hongph713/IOT_DATN/DATN_Hong/DATN_Hong.kicad_pcb

## KiCad design DATN_Hong/DATN_Hong.kicad_pcb (2025-06-25)

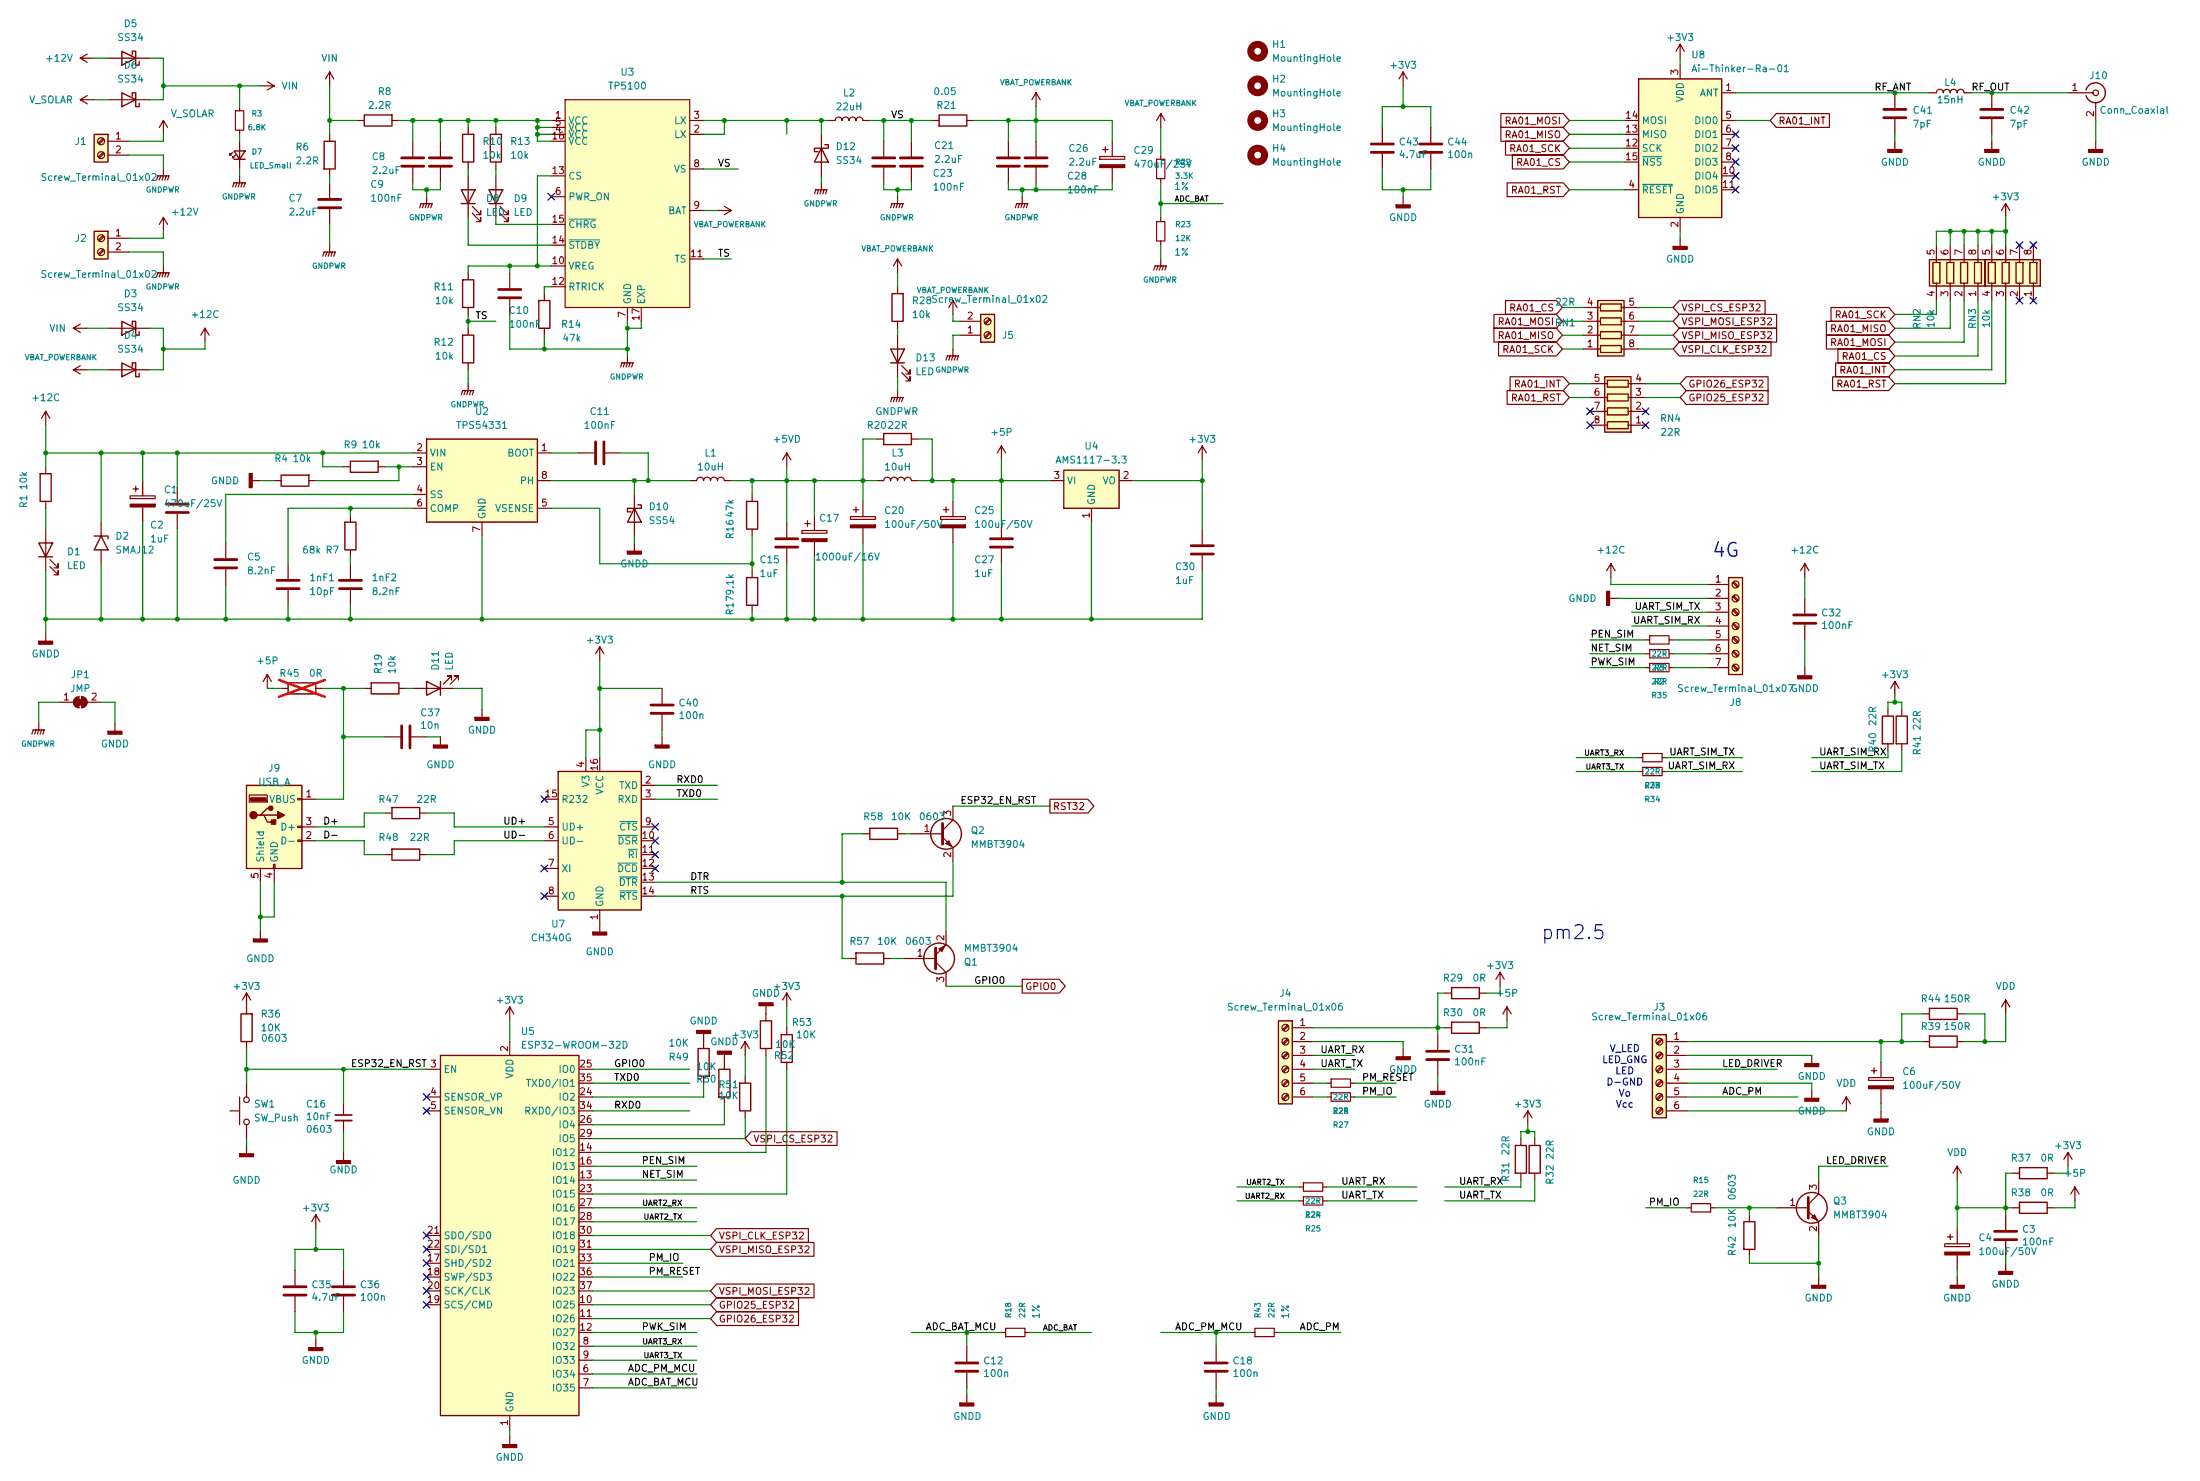
[picture p1: schematic DATN_Hong.kicad_sch]

Parts:
1nF1: 10pF; C_0603_1608Metric
1nF2: 8.2nF; C_0603_1608Metric
C1, C29: 470uF/25V; CP_Elec_10x10.5
C2, C15, C27, C30: 1uF; C_1206_3216Metric
C3, C31, C32: 100nF; C_0603_1608Metric; Part Description 10uF 10% 10V Ceramic Capacitor X7R 0805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
C4, C6, C20, C25: 100uF/50V; CP_EIA-7343-15_Kemet-W
C5: 8.2nF; C_0603_1608Metric
C7, C8, C21, C26: 2.2uF; C_1206_3216Metric
C9, C10, C11, C23, C28: 100nF; C_0603_1608Metric
C12, C18, C36, C44: 100n; C_0603_1608Metric; PART#1 G030617
C16: 10nF; C_0603_1608Metric; VOLTAGE 25V; PART#1 C021101
C17: 1000uF/16V; CP_Elec_10x10
C35, C43: 4.7uF; C_1206_3216Metric; PART#1 C020609
C37: 10n; C_0603_1608Metric
C40: 100n; C_0603_1608Metric
C41, C42: 7pF; C_0603_1608Metric
D1, D8, D9, D11, D13: LED; LED_0603_1608Metric
D2: SMAJ12; D_SMA
D3, D4, D5, D6, D12: SS34; D_SMA
D7: LED_Small; LED_0603_1608Metric
D10: SS54; D_SMA
H1, H2, H3, H4: MountingHole; MountingHole_3.2mm_M3
J1, J2, J5: Screw_Terminal_01x02; JST_VH_B2P-VH-B_1x02_P3.96mm_Vertical
J3, J4: Screw_Terminal_01x06; TerminalBlock_Xinya_XY308-2.54-6P_1x06_P2.54mm_Horizontal
J8: Screw_Terminal_01x07; PinHeader_1x07_P2.54mm_Vertical
J9: USB_A; USB_B_OST_USB-B1HSxx_Horizontal
J10: Conn_Coaxial; SMA_Amphenol_132291-12_Vertical
JP1: JMP; SolderJumper-2_P1.3mm_Bridged2Bar_RoundedPad1.0x1.5mm
L1: 10uH; L_12x12mm_H8mm
L2: 22uH; L_10.4x10.4_H4.8
L3: 10uH; L_Bourns-SRN4018
L4: 15nH; L_0603_1608Metric
Q1, Q2, Q3: MMBT3904; SOT-23
R1, R4, R9, R10, R11, R12, R13, R19, R28: 10k; R_0603_1608Metric
R2, R5, R15, R18, R24, R25, R26, R27, R33, R34, R35, R43, R47, R48: 22R; R_0603_1608Metric
R3: 6.8K; R_0603_1608Metric
R6, R8: 2.2R; R_1206_3216Metric
R7: 68k; R_0603_1608Metric
R14, R16: 47k; R_0603_1608Metric
R17: 9.1k; R_0603_1608Metric
R20: 22R; R_1206_3216Metric
R21: 0.05; R_1206_3216Metric
R22: 3.3K; R_0603_1608Metric; PART CLA0759
R23: 12K; R_0603_1608Metric
R29, R30, R37, R38: 0R; R_0603_1608Metric; Part Description Resistor 510K M1005 1% 63mW
R31, R32, R40, R41: 22R; R_0603_1608Metric; Part Description Resistor 510K M1005 1% 63mW
R36, R42, R49, R50, R51, R52, R53, R57, R58: 10K; R_0603_1608Metric
R39: 150R; R_1206_3216Metric; Part Description Resistor 510K M1005 1% 63mW
R44: 150R; R_Axial_DIN0207_L6.3mm_D2.5mm_P7.62mm_Horizontal; Part Description Resistor 510K M1005 1% 63mW
R45: 0R; R_0603_1608Metric; Part Description Resistor 510K M1005 1% 63mW; not fitted
RN1, RN4: 22R; R_Array_Convex_4x0603
RN2, RN3: 10k; R_Array_Convex_4x0603
SW1: SW_Push; SW_SPST_CK_RS282G05A3
U2: TPS54331; SOIC-8_3.9x4.9mm_P1.27mm
U3: TP5100; QFN-16-1EP_4x4mm_P0.65mm_EP2.1x2.1mm_ThermalVias
U4: AMS1117-3.3; SOT-223-3_TabPin2
U5: ESP32-WROOM-32D
U7: CH340G; SOIC-16_3.9x9.9mm_P1.27mm
U8: Ai-Thinker-Ra-01; Ai-Thinker-Ra-01-LoRa

Connections:
+3V3: C30.1, C35.1, C36.1, C40.1, C43.1, C44.1, R29.1, R31.1, R32.1, R36.2, R37.1, R40.1, R41.1, R51.2, R53.2, RN2.5 (R4.2), RN2.6 (R3.2), RN2.7 (R2.2), RN2.8 (R1.2), RN3.5 (R4.2), RN3.6 (R3.2), U4.2 (VO), U5.2 (VDD), U7.4 (V3), U7.16 (VCC), U8.3 (VDD)
+5P: C25.1, C27.1, L3.2, R20.2, R30.1, R38.1, R45.2, U4.3 (VI)
+5VD: C15.1, C17.1, C20.1, L1.2, L3.1, R16.2, R20.1
+12C: C1.1, C2.1, C32.1, D2.1 (A1), D3.1 (K), D4.1 (K), J8.1, R1.2, R9.1, U2.2 (VIN)
+12V: D5.2 (A), J2.1
/ADC_BAT: R18.2, R22.2, R23.1
/ADC_BAT_MCU: C12.1, R18.1, U5.7 (IO35)
/ADC_PM: J3.5, R43.2
/ADC_PM_MCU: C18.1, R43.1, U5.6 (IO34)
/D+: J9.3 (D+), R47.2
/D-: J9.2 (D-), R48.2
/DTR: Q1.2 (E), R58.2, U7.13 (~DTR)
/LED_DRIVER: J3.3, Q3.3 (C)
/NET_SIM: R2.1, U5.13 (IO14)
/PEN_SIM: R5.1, U5.16 (IO13)
/PM_IO: R15.2, R27.2, U5.33 (IO21)
/PM_RESET: R26.2, U5.36 (IO22)
/PWK_SIM: R35.1, U5.12 (IO27)
/RF_ANT: C41.1, L4.1, U8.1 (ANT)
/RF_OUT: C42.1, J10.1 (In), L4.2
/RTS: Q2.2 (E), R57.2, U7.14 (~RTS)
/RXD0: U5.34 (RXD0/IO3), U7.2 (TXD)
/TS: R11.1, R12.2, U3.11 (TS)
/TXD0: U5.35 (TXD0/IO1), U7.3 (RXD)
/UART2_RX: R25.1, U5.27 (IO16)
/UART2_TX: R24.1, U5.28 (IO17)
/UART3_RX: R33.1, U5.8 (IO32)
/UART3_TX: R34.1, U5.9 (IO33)
/UART_RX: J4.3, R24.2, R31.2
/UART_SIM_RX: J8.4, R34.2, R40.2
/UART_SIM_TX: J8.3, R33.2, R41.2
/UART_TX: J4.4, R25.2, R32.2
/UD+: R47.1, U7.5 (UD+)
/UD-: R48.1, U7.6 (UD-)
/VS: C21.1, C23.2, L2.2, R21.2, U3.8 (VS)
GNDD: 1nF1.2, 1nF2.2, C1.2, C2.2, C3.2, C4.2, C5.2, C6.2, C12.2, C15.2, C16.2, C17.2, C18.2, C20.2, C25.2, C27.2, C30.2, C31.2, C32.2, C35.2, C36.2, C37.1, C40.2, C41.2, C42.2, C43.2, C44.2, D1.1 (K), D2.2 (A2), D10.2 (A), D11.1 (K), J3.2, J3.4, J4.2, J8.2, J9.4 (GND), J9.5 (Shield), J10.2 (Ext), JP1.2 (B), Q3.2 (E), R4.1, R17.1, R42.2, R49.1, R50.1, R52.1, SW1.1, U2.7 (GND), U4.1 (GND), U5.1 (GND), U5.15 (GND), U5.38 (GND), U5.39 (GND), U7.1 (GND), U8.2 (GND), U8.9 (GND), U8.16 (GND)
GNDPWR: C7.2, C8.2, C9.1, C10.1, C21.2, C23.1, C26.2, C28.1, C29.2, D7.1 (K), D12.2 (A), D13.1 (K), J1.2, J2.2, J5.1, JP1.1 (A), R12.1, R14.1, R23.2, U3.7 (GND), U3.17 (EXP)
GPIO0: Q1.3 (C), U5.25 (IO0)
GPIO25_ESP32: RN4.3 (R3.1), U5.10 (IO25)
GPIO26_ESP32: RN4.4 (R4.1), U5.11 (IO26)
unnamed: 1nF2.1, R7.1
unnamed: C7.1, R6.2
unnamed: C8.1, C9.2, R8.2, R10.2, R13.2, U3.1 (VCC), U3.4 (VCC), U3.5 (VCC), U3.16 (VCC)
unnamed: D1.2 (A), R1.1
unnamed: D7.2 (A), R3.2
unnamed: D8.2 (A), R10.1
unnamed: D8.1 (K), U3.14 (~STDBY)
unnamed: D9.2 (A), R13.1
unnamed: D9.1 (K), U3.15 (~CHRG)
unnamed: C11.2, D10.1 (K), L1.1, U2.8 (PH)
unnamed: D11.2 (A), R19.1
unnamed: D12.1 (K), L2.1, U3.2 (LX), U3.3 (LX)
unnamed: D13.2 (A), R28.1
unnamed: C6.1, J3.1, R39.2, R44.2
unnamed: C31.1, J4.1, R29.2, R30.2
unnamed: J4.5, R26.1
unnamed: J4.6, R27.1
unnamed: J8.5, R5.2
unnamed: J8.6, R2.2
unnamed: J8.7, R35.2
unnamed: C37.2, J9.1 (VBUS), R19.2, R45.1
unnamed: Q1.1 (B), R57.1
unnamed: Q2.1 (B), R58.1
unnamed: Q3.1 (B), R15.1, R42.1
unnamed: C11.1, U2.1 (BOOT)
unnamed: 1nF1.1, R7.2, U2.6 (COMP)
unnamed: R4.2, R9.2, U2.3 (EN)
unnamed: C5.1, U2.4 (SS)
unnamed: R16.1, R17.2, U2.5 (VSENSE)
unnamed: C10.2, R11.2, U3.10 (VREG), U3.13 (CS)
unnamed: R14.2, U3.12 (RTRICK)
unnamed: R49.2, U5.24 (IO2)
unnamed: R50.2, U5.26 (IO4)
unnamed: R52.2, U5.14 (IO12)
unnamed: R53.1, U5.23 (IO15)
RA01_CS: RN1.4 (R4.1), RN2.1 (R1.1), U8.15 (~NSS)
RA01_INT: RN3.4 (R4.1), RN4.5 (R4.2), U8.5 (DIO0)
RA01_MISO: RN1.2 (R2.1), RN2.3 (R3.1), U8.13 (MISO)
RA01_MOSI: RN1.3 (R3.1), RN2.2 (R2.1), U8.14 (MOSI)
RA01_RST: RN3.3 (R3.1), RN4.6 (R3.2), U8.4 (~RESET)
RA01_SCK: RN1.1 (R1.1), RN2.4 (R4.1), U8.12 (SCK)
RST32: C16.1, Q2.3 (C), R36.1, SW1.2, U5.3 (EN)
VBAT_POWERBANK: C26.1, C28.2, C29.1, D4.2 (A), J5.2, R21.1, R22.1, R28.2, U3.9 (BAT)
VDD: C3.1, C4.1, J3.6, R37.2, R38.2, R39.1, R44.1
VIN: D3.2 (A), D5.1 (K), D6.1 (K), R3.1, R6.1, R8.1
VSPI_CLK_ESP32: RN1.8 (R1.2), U5.30 (IO18)
VSPI_CS_ESP32: R51.1, RN1.5 (R4.2), U5.29 (IO5)
VSPI_MISO_ESP32: RN1.7 (R2.2), U5.31 (IO19)
VSPI_MOSI_ESP32: RN1.6 (R3.2), U5.37 (IO23)
V_SOLAR: D6.2 (A), J1.1

Notes on the sheet:
V_LED LED_GNG LED D-GND Vo Vcc
pm2.5

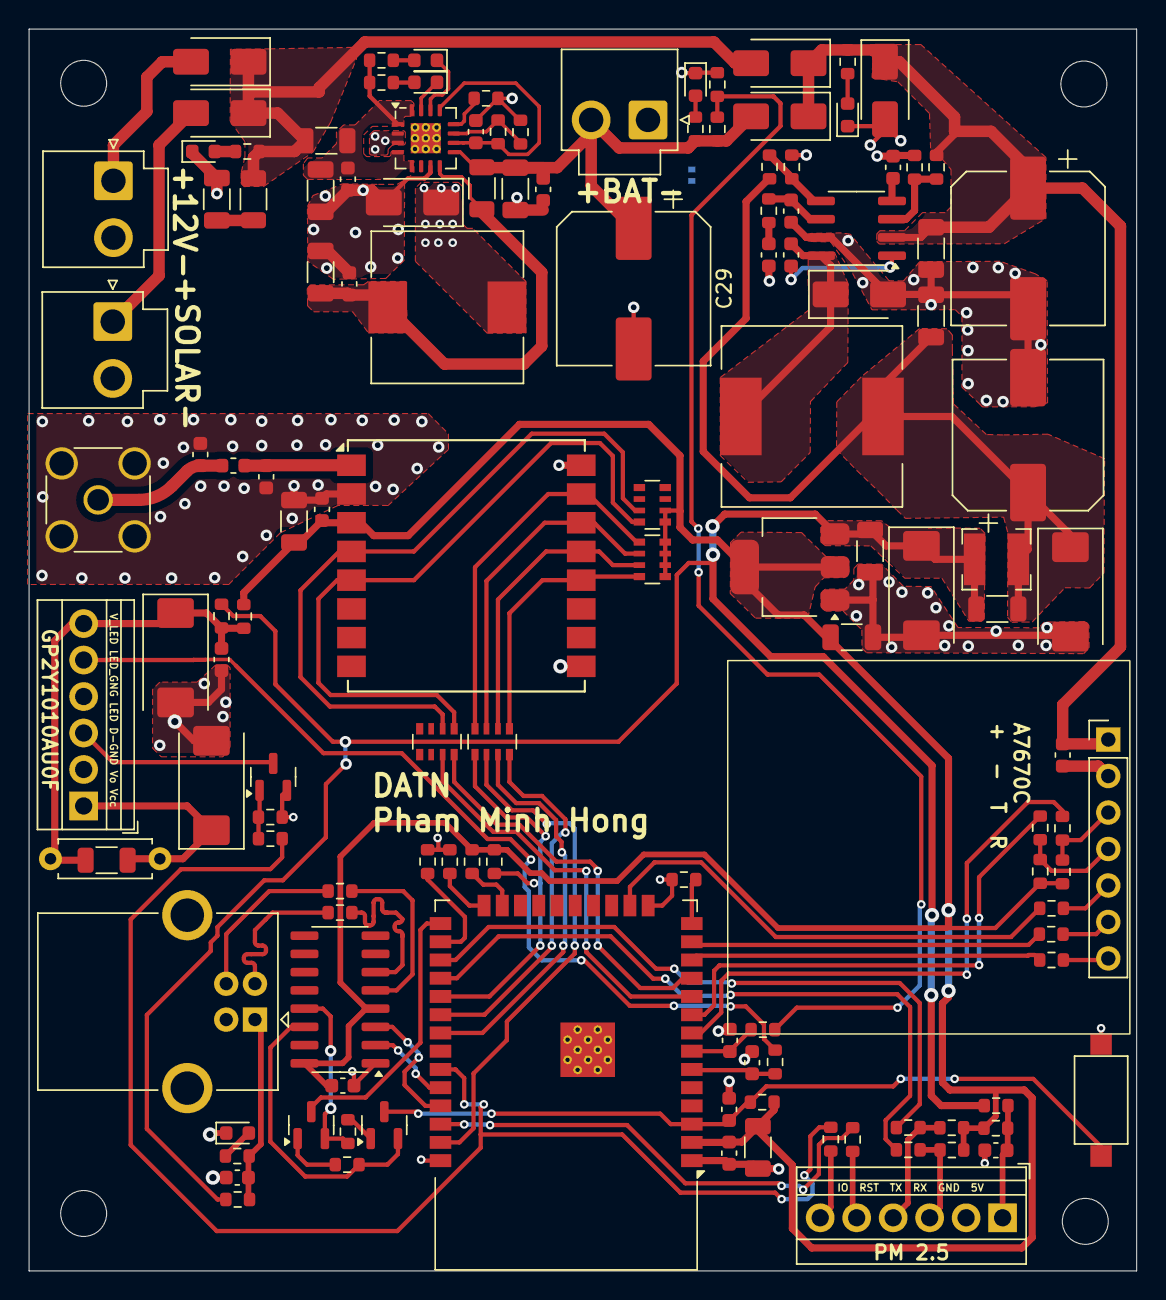
[picture p2: board DATN_Hong.kicad_pcb from above]

Board: 2 copper layers, 77.1 x 86.5 mm, 135 parts (1 on the bottom side), 90 nets.
